fablabbcn/smartcitizen-enclosures/docs/Power Options/Power hub/power-routing/power-routing.kicad_pcb

## KiCad design docs/Power Options/Power hub/power-routing/power-routing.kicad_pcb (2023-01-04)

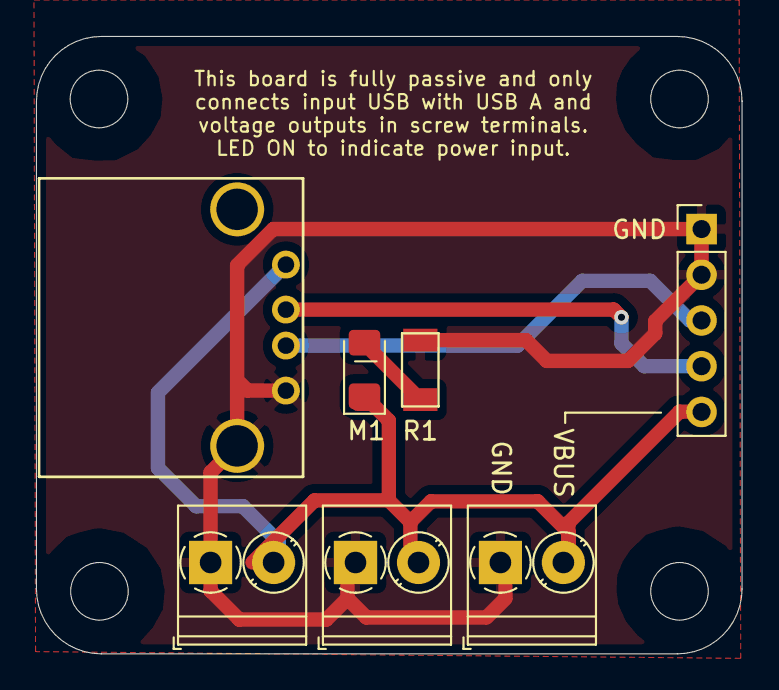
[picture p2: board power-routing.kicad_pcb from above]

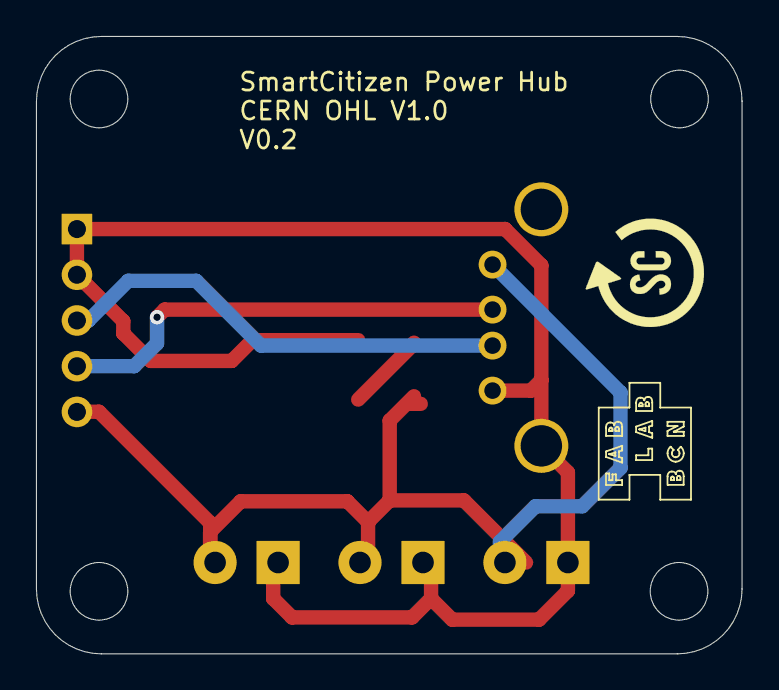
[picture p3: board power-routing.kicad_pcb from below]

Board: 2 copper layers, 39.2 x 34.3 mm, 13 parts (2 on the bottom side), 5 nets.

Parts:
H1, H2, H3, H4: MountingHole; MountingHole_3.2mm_M3
J1: Input_Bulgin; PinHeader_1x05_P2.54mm_Vertical
J2, J3, J4: Screw_Terminal_01x02; TerminalBlock_Phoenix_PT-1,5-2-3.5-H_1x02_P3.50mm_Horizontal
J6: USB_A; USB_A_Amphenol_87520-1110BLF
M1: RED; LED_1206_3216Metric_Pad1.42x1.75mm_HandSolder
R1: 220Ω; fab-R1206FAB
U1: fablab
U2: smartcitizen

Connections:
D+: J1.3, J6.3
D-: J1.4, J6.2
GND: J1.1, J1.2, J2.1, J3.1, J4.1, J6.4, J6.5, R1.2
unnamed: M1.2, R1.1
VBUS: J1.5, J2.2, J3.2, J4.2, J6.1, M1.1
