fablabbcn/smartcitizen-enclosures/docs/Power Options/PowerSupply/PowerSupply.kicad_pcb

## KiCad design docs/Power Options/PowerSupply/PowerSupply.kicad_pcb (2020-03-18)

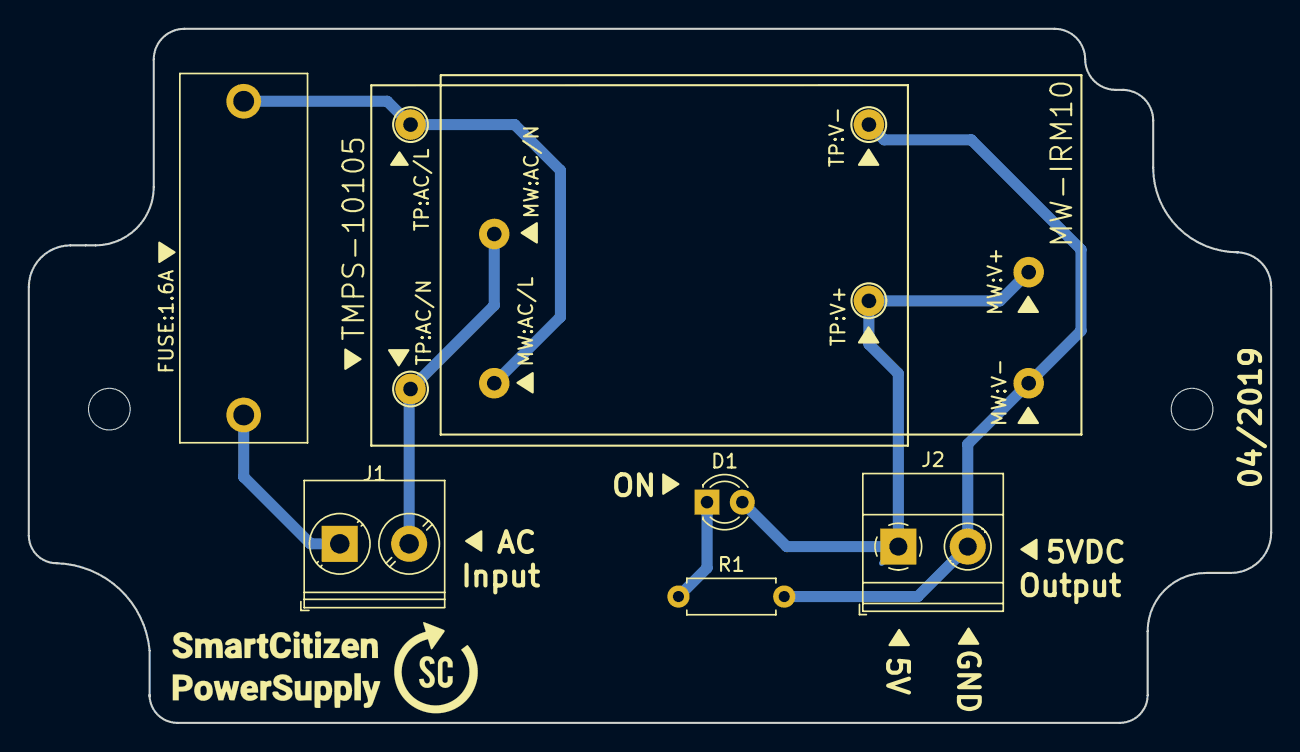
[picture p4: board PowerSupply.kicad_pcb from above]

Board: 2 copper layers, 89.5 x 50.0 mm, 7 parts (0 on the bottom side), 6 nets.

Parts:
D1: LED_RED; LED_D3.0mm
FUSE:1.6A: Fuse; Fuse_Littelfuse_646Series
J1: Screw_Terminal_01x02-AC_INPUT; TerminalBlock_Phoenix_PT-2,5-2-5.0-H_1x02_P5.00mm_Horizontal
J2: Screw_Terminal_01x02-DC_OUTPUT; TerminalBlock_Phoenix_MKDS-1,5-2_1x02_P5.00mm_Horizontal
MW-IRM10: MeanWell-IRM-10; MeanWell-IRM-10-5
R1: 1.8kOhm; R_Axial_DIN0207_L6.3mm_D2.5mm_P7.62mm_Horizontal
TMPS-10105: TracoPower-TMPS-10105; Traco-TMPS-10-105

Connections:
unnamed: D1.1, R1.1
unnamed: D1.2, J2.1, MW-IRM10.4, TMPS-10105.4
unnamed: FUSE:1.6A.1, MW-IRM10.2, TMPS-10105.2
unnamed: FUSE:1.6A.2, J1.1
unnamed: J1.2, MW-IRM10.1, TMPS-10105.1
unnamed: J2.2, MW-IRM10.3, R1.2, TMPS-10105.3
