fablabbcn/smartcitizen-enclosures/docs/Water/Electronics/SmartCitizen Water Station/Isolated Carriers Station/CarrierBoardBus/i2c_bus_carriers_x5.kicad_pcb

## KiCad design docs/Water/Electronics/SmartCitizen Water Station/Isolated Carriers Station/CarrierBoardBus/i2c_bus_carriers_x5.kicad_pcb (2023-07-11)

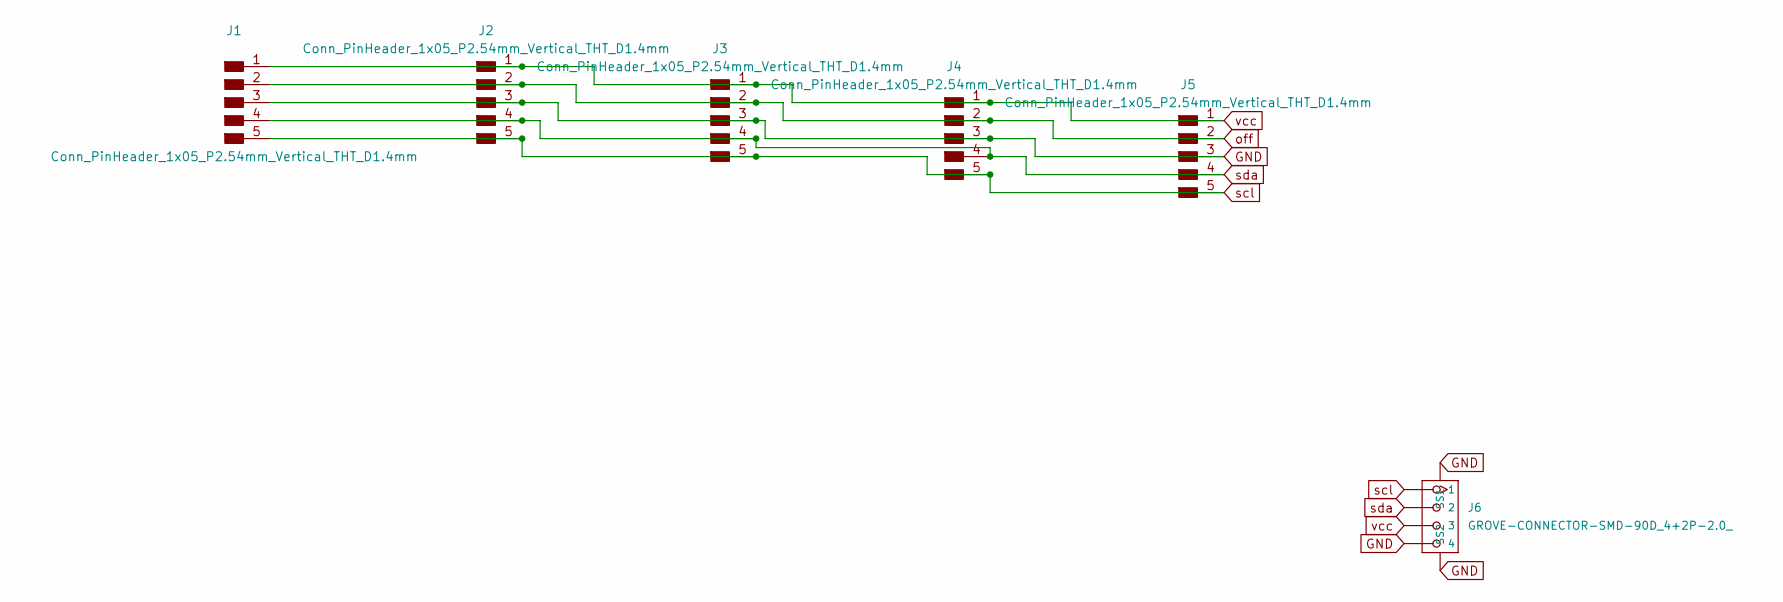
[picture p5: schematic i2c_bus_carriers_x5.kicad_sch]

Parts:
J1, J2, J3, J4, J5: Conn_PinHeader_1x05_P2.54mm_Vertical_THT_D1.4mm; PinHeader_1x05_P2.54mm_Vertical_THT_D1.4mm
J6: GROVE-CONNECTOR-SMD-90D_4+2P-2.0_; HW4-SMD-2.0-90D

Connections:
GND: J1.3, J2.3, J3.3, J4.3, J5.3, J6.4, J6.5 (SS1), J6.6 (SS2)
off: J1.2, J2.2, J3.2, J4.2, J5.2
scl: J1.5, J2.5, J3.5, J4.5, J5.5, J6.1
sda: J1.4, J2.4, J3.4, J4.4, J5.4, J6.2
vcc: J1.1, J2.1, J3.1, J4.1, J5.1, J6.3

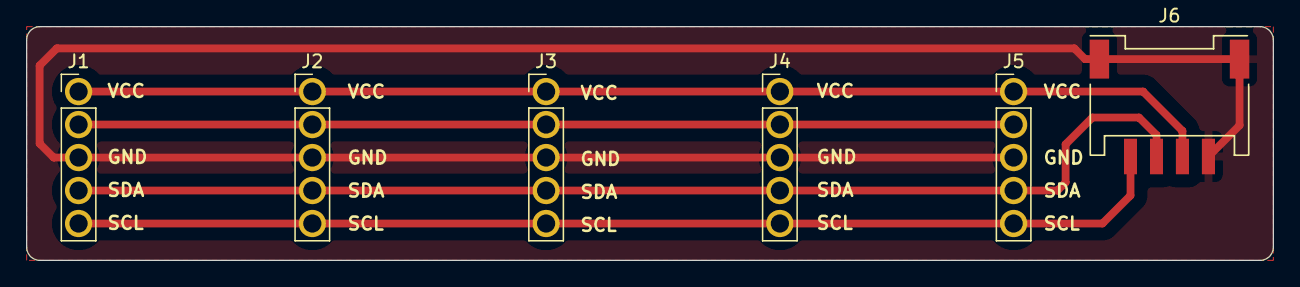
[picture p6: board i2c_bus_carriers_x5.kicad_pcb from above]

Board: 2 copper layers, 96.0 x 18.0 mm, 6 parts (0 on the bottom side), 5 nets.
