fablabbcn/smartcitizen-enclosures/SmartCitizen Water Enclosures/SmartCitizen Water Station/Tentacle Water Station/TentacleShield/TentacleShield/TentacleShield.kicad_pcb

## KiCad design SmartCitizen Water Enclosures/SmartCitizen Water Station/Tentacle Water Station/TentacleShield/TentacleShield/TentacleShield.kicad_pcb (2023-01-04)

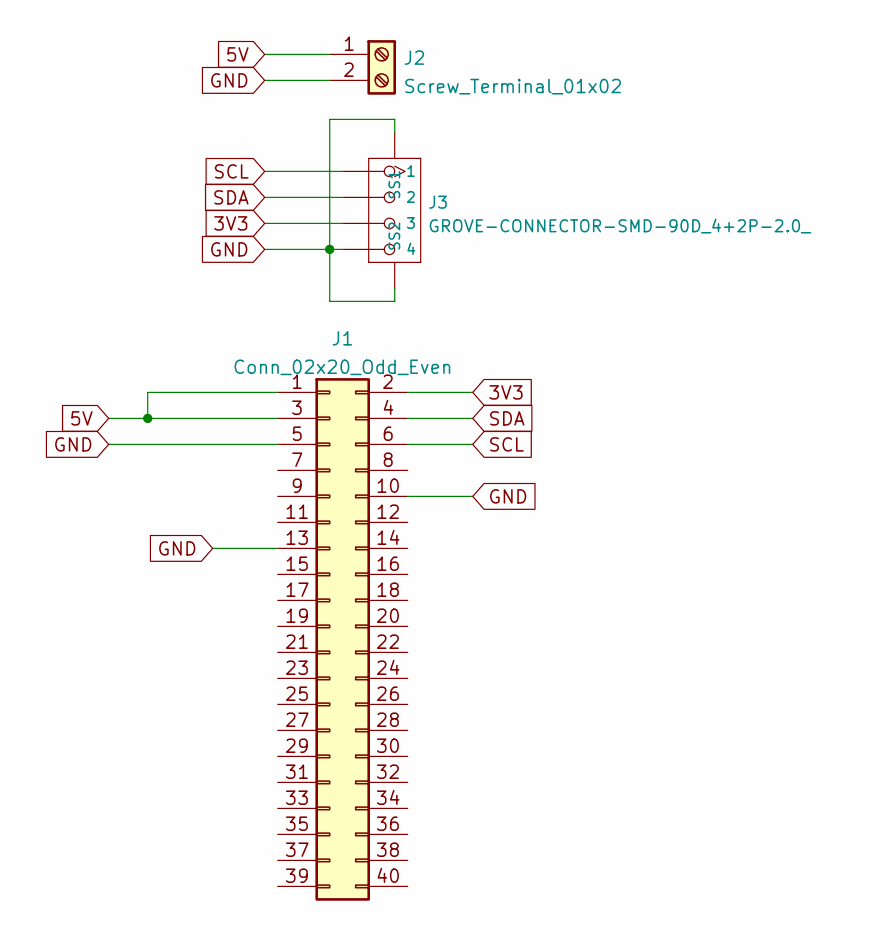
[picture p7: schematic TentacleShield.kicad_sch]

Parts:
J1: Conn_02x20_Odd_Even; PinSocket_2x20_P2.54mm_Vertical
J2: Screw_Terminal_01x02; TerminalBlock_Phoenix_PT-1,5-2-3.5-H_1x02_P3.50mm_Horizontal
J3: GROVE-CONNECTOR-SMD-90D_4+2P-2.0_; HW4-SMD-2.0-90D

Connections:
3V3: J1.2, J3.3
5V: J1.1, J1.3, J2.1
GND: J1.5, J1.10, J1.13, J2.2, J3.4, J3.5 (SS1), J3.6 (SS2)
SCL: J1.6, J3.1
SDA: J1.4, J3.2

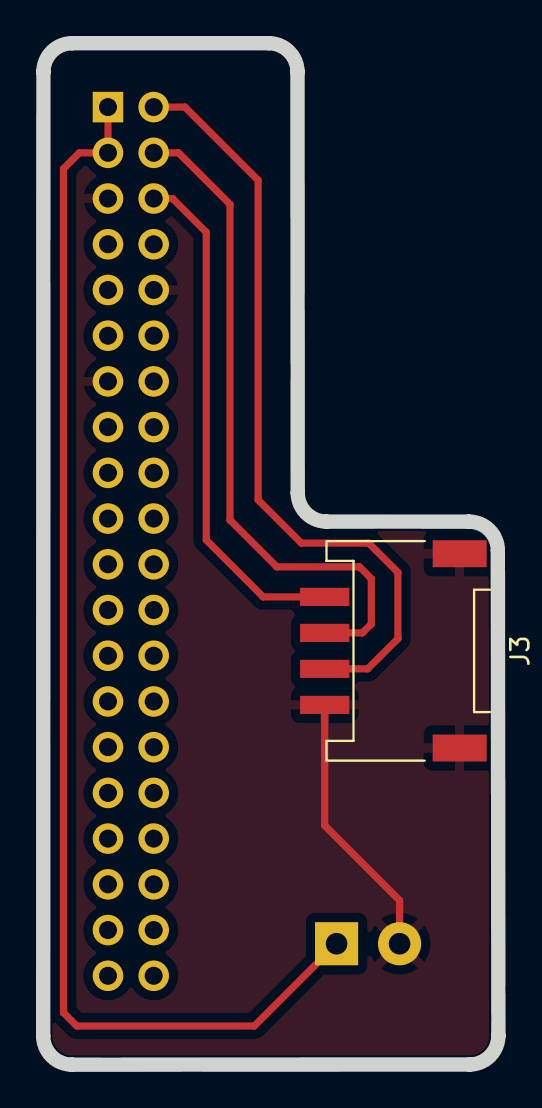
[picture p8: board TentacleShield.kicad_pcb from above]

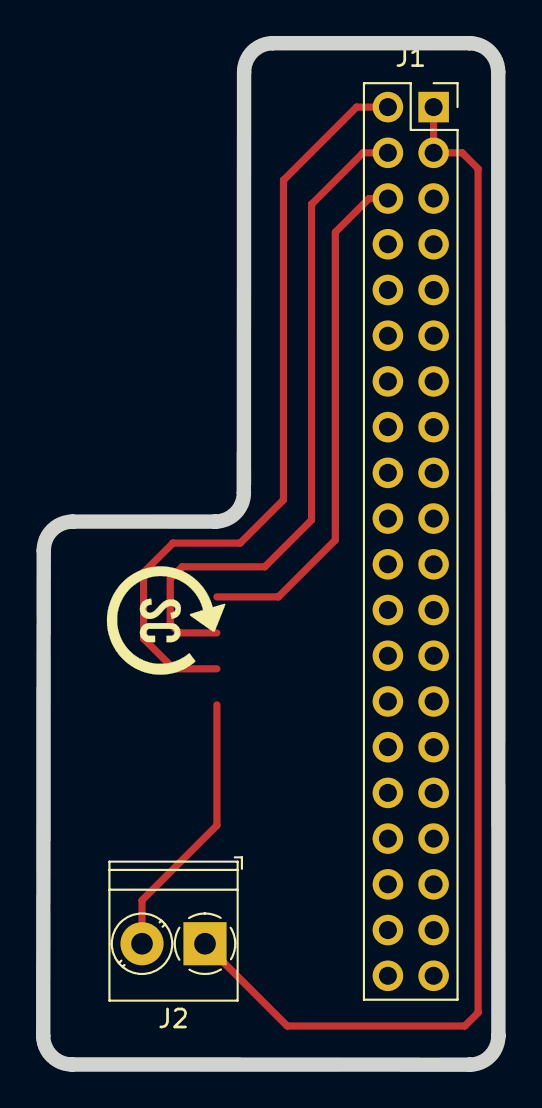
[picture p9: board TentacleShield.kicad_pcb from below]

Board: 2 copper layers, 25.3 x 56.7 mm, 3 parts (2 on the bottom side), 5 nets.
