fablabbcn/smartcitizen-enclosures/(notices)

Notices in the files:
docs/Power Options/Power hub/power-routing/power-routing.kicad_pcb:
CERN OHL V1.0
